inverseTrig/odderball/output/dxf/mcuHolder.dxf

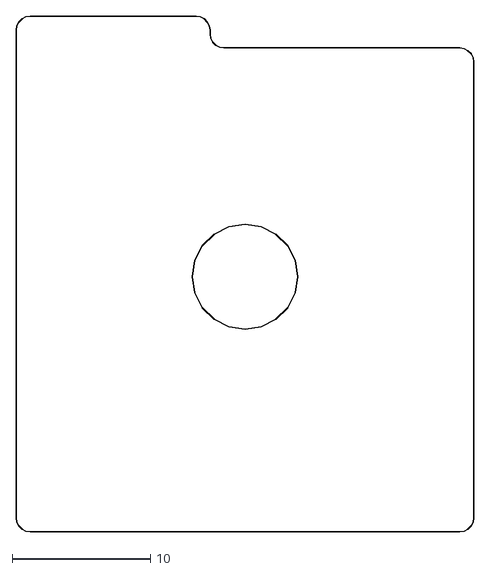
[picture p1: CAD file, 2024-08-11]
output/dxf/mcuHolder.dxf
33.0 x 37.2
