inverseTrig/odderball/src/modules/pcb.dxf

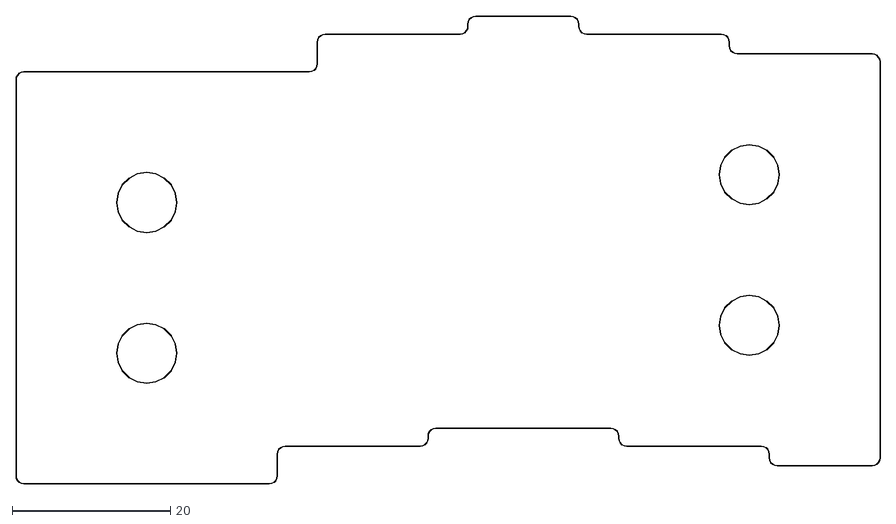
[picture p2: CAD file, 2024-08-10]
src/modules/pcb.dxf
109.3 x 59.1
