inverseTrig/odderball/output/dxf/rightThumbPlate.dxf

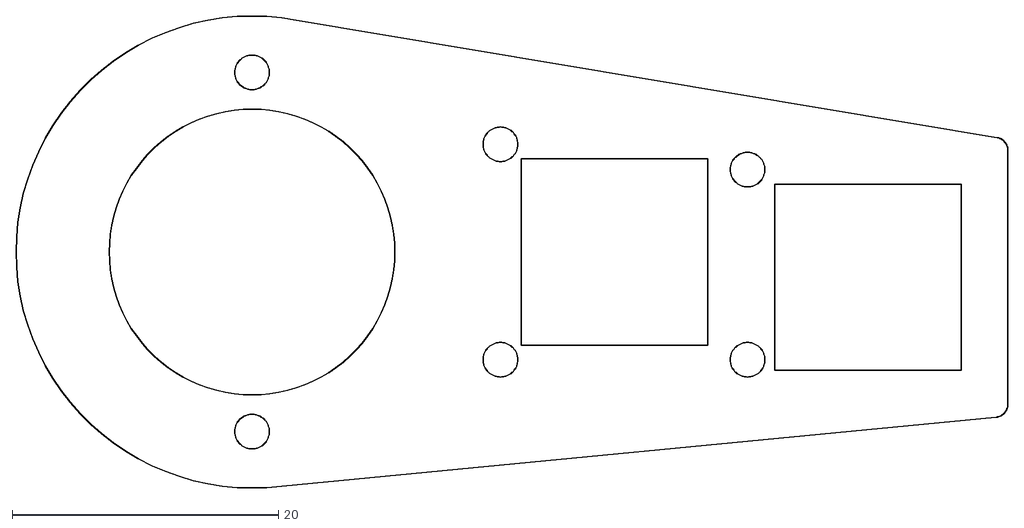
[picture p3: CAD file, 2024-08-10]
output/dxf/rightThumbPlate.dxf
74.6 x 35.5
