inverseTrig/odderball/src/modules/case.stl

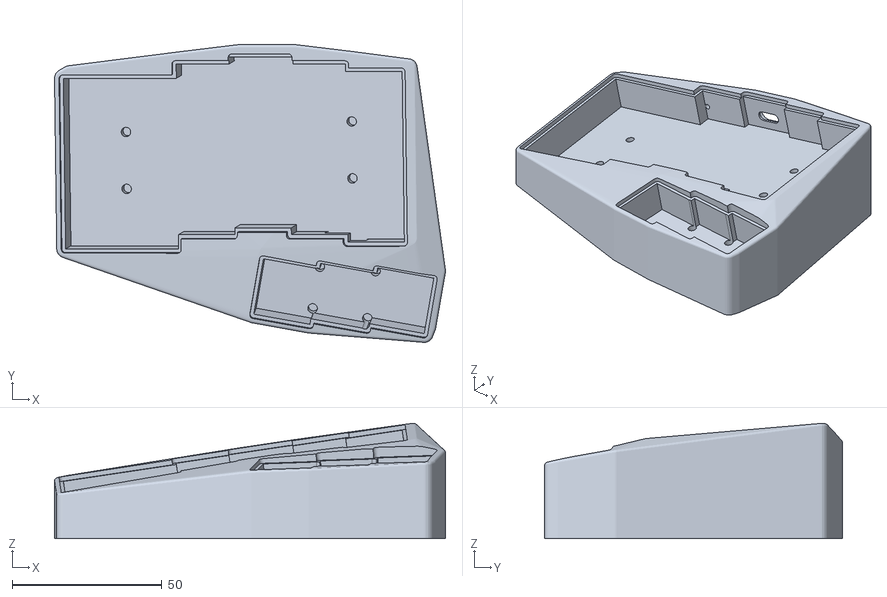
[picture p4: CAD file, 2024-08-10]
src/modules/case.stl
130.4 x 99.3 x 38.4
