inverseTrig/odderball/output/dxf/thumbPcb.dxf

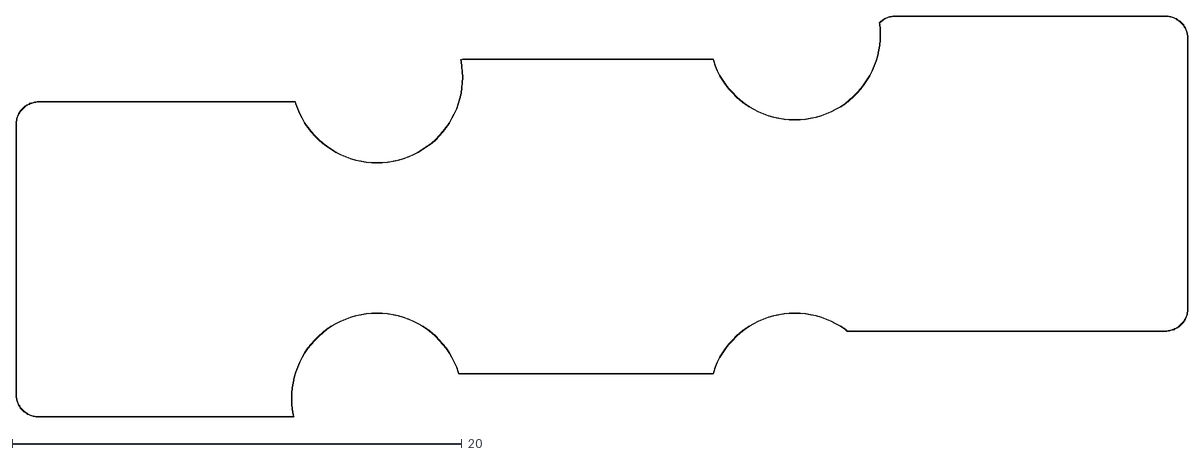
[picture p5: CAD file, 2024-08-10]
output/dxf/thumbPcb.dxf
52.1 x 17.8
