inverseTrig/odderball/output/dxf/leftThumbPlate.dxf

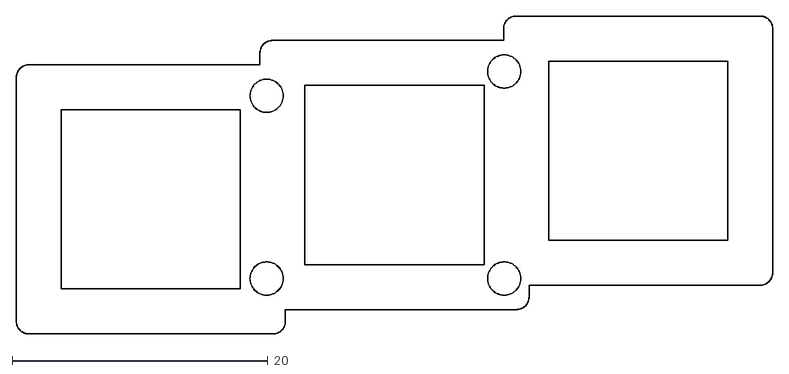
[picture p6: CAD file, 2024-08-10]
output/dxf/leftThumbPlate.dxf
59.2 x 24.9
