inverseTrig/odderball/src/components/thumbPcbDxf.scad

include<../config.scad>;
use<../modules/pcb.scad>;

pcb(
    THUMB_GRID,
    THUMB_BOLT_HOLES,
    1.00,
    $fn = 100);
