inverseTrig/odderball/(list of files, cad)

Other CAD files:
src/components/rightPlateDxf.scad
src/modules/leftCase.scad
