inverseTrig/odderball/pcb/odderball.kicad_pcb

## KiCad design pcb/odderball.kicad_pcb (2024-08-10)

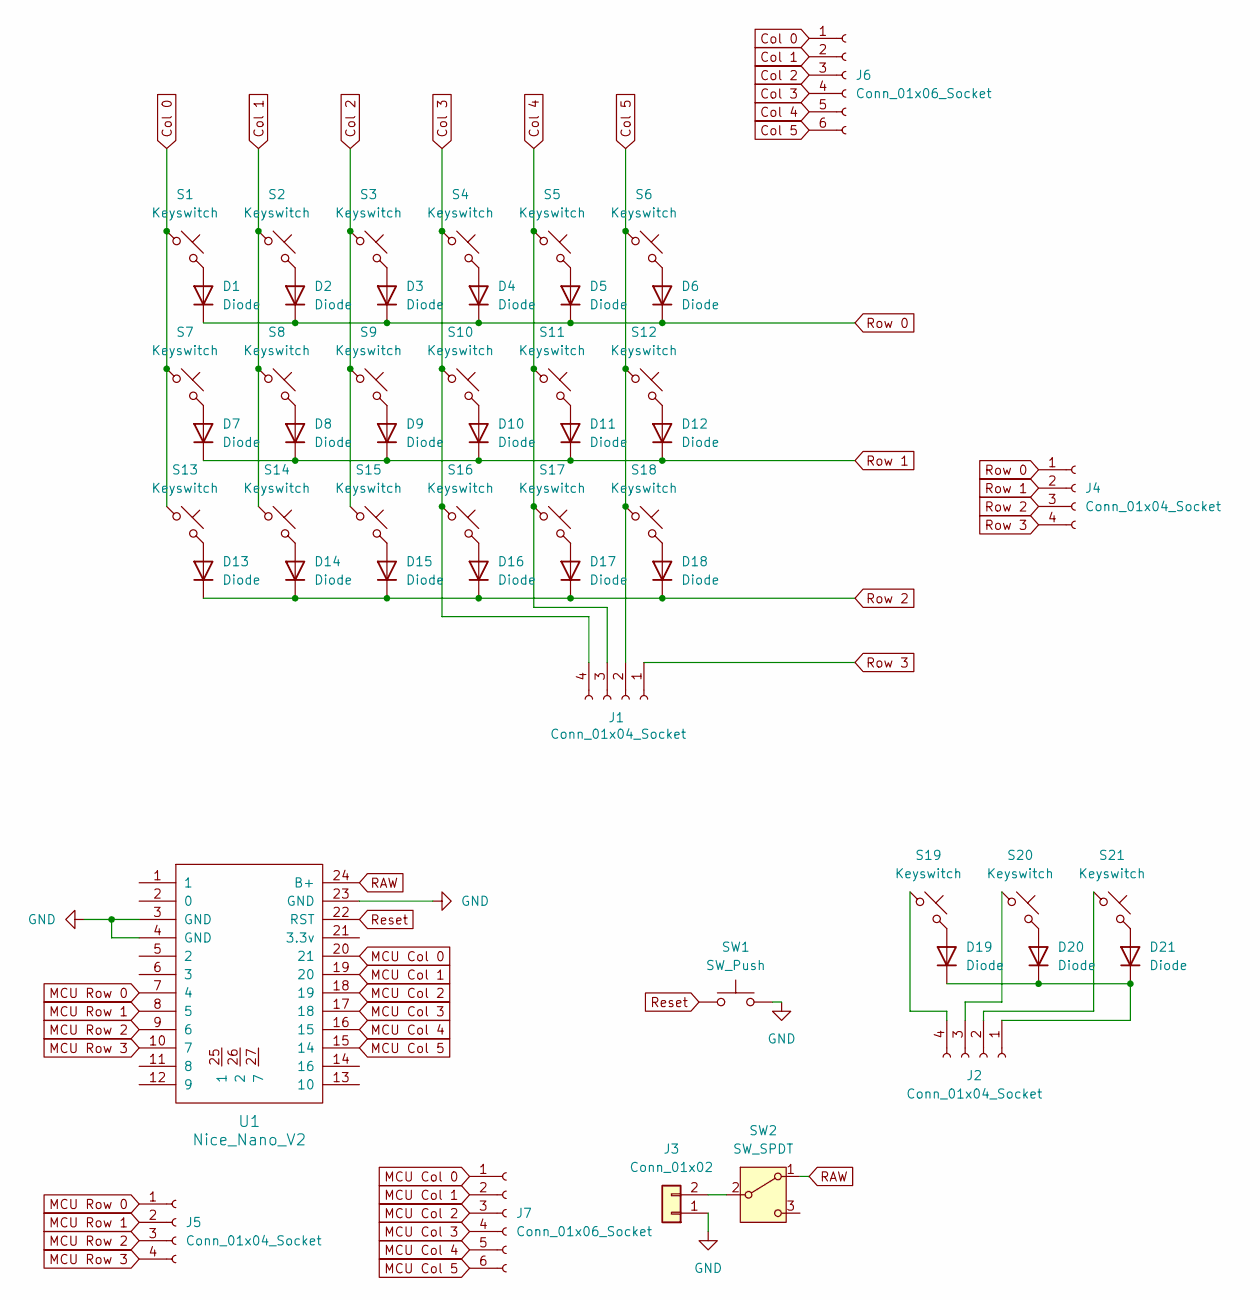
[picture p7: schematic odderball.kicad_sch]

Parts:
D1, D2, D3, D4, D5, D6, D7, D8, D9, D10, D11, D12, D13, D14, D15, D16, D17, D18, D19, D20, D21: Diode; Diode_TH_SOD123
J1, J2, J4, J5: Conn_01x04_Socket; PinSocket_1x04_P2.54mm_Vertical
J3: Conn_01x02; JST_PH_S2B-PH-SM4-TB_1x02-1MP_P2.00mm_Horizontal
J6, J7: Conn_01x06_Socket; PinSocket_1x06_P2.54mm_Vertical
S1, S2, S3, S4, S5, S6, S7, S8, S9, S10, S11, S12, S13, S14, S15, S16, S17, S18, S19, S20, S21: Keyswitch; MX_Solder_1.00u_Reversible
SW1: SW_Push; alps_sksn
SW2: SW_SPDT; switch_SSSS811101
U1: Nice_Nano_V2

Connections:
Col 0: J6.1, S1.1, S7.1, S13.1
Col 1: J6.2, S2.1, S8.1, S14.1
Col 2: J6.3, S3.1, S9.1, S15.1
Col 3: J1.4, J6.4, S4.1, S10.1, S16.1
Col 4: J1.3, J6.5, S5.1, S11.1, S17.1
Col 5: J1.2, J6.6, S6.1, S12.1, S18.1
GND: J3.1, SW1.2, U1.3 (GND), U1.4 (GND), U1.23 (GND)
MCU Col 0: J7.1, U1.20 (21)
MCU Col 1: J7.2, U1.19 (20)
MCU Col 2: J7.3, U1.18 (19)
MCU Col 3: J7.4, U1.17 (18)
MCU Col 4: J7.5, U1.16 (15)
MCU Col 5: J7.6, U1.15 (14)
MCU Row 0: J5.1, U1.7 (4)
MCU Row 1: J5.2, U1.8 (5)
MCU Row 2: J5.3, U1.9 (6)
MCU Row 3: J5.4, U1.10 (7)
unnamed: D1.2 (A), S1.2
unnamed: D2.2 (A), S2.2
unnamed: D3.2 (A), S3.2
unnamed: D4.2 (A), S4.2
unnamed: D5.2 (A), S5.2
unnamed: D6.2 (A), S6.2
unnamed: D7.2 (A), S7.2
unnamed: D8.2 (A), S8.2
unnamed: D9.2 (A), S9.2
unnamed: D10.2 (A), S10.2
unnamed: D11.2 (A), S11.2
unnamed: D12.2 (A), S12.2
unnamed: D13.2 (A), S13.2
unnamed: D14.2 (A), S14.2
unnamed: D15.2 (A), S15.2
unnamed: D16.2 (A), S16.2
unnamed: D17.2 (A), S17.2
unnamed: D18.2 (A), S18.2
unnamed: D19.2 (A), S19.2
unnamed: D19.1 (K), D20.1 (K), D21.1 (K), J2.1
unnamed: D20.2 (A), S20.2
unnamed: D21.2 (A), S21.2
unnamed: J2.2, S21.1
unnamed: J2.3, S20.1
unnamed: J2.4, S19.1
unnamed: J3.2, SW2.2 (B)
RAW: SW2.1 (A), U1.24 (B+)
Reset: SW1.1, U1.22 (RST)
Row 0: D1.1 (K), D2.1 (K), D3.1 (K), D4.1 (K), D5.1 (K), D6.1 (K), J4.1
Row 1: D7.1 (K), D8.1 (K), D9.1 (K), D10.1 (K), D11.1 (K), D12.1 (K), J4.2
Row 2: D13.1 (K), D14.1 (K), D15.1 (K), D16.1 (K), D17.1 (K), D18.1 (K), J4.3
Row 3: J1.1, J4.4

Board: 2 copper layers, 52 parts (21 on the bottom side), 49 nets, no tracks yet.
