inverseTrig/odderball/(commit log)

2024-07-26 feat: add extra thumb key; add more bolt holes for support; change thumb keys to 1u
    [case.scad, config.scad, leftCase.scad, rightCase.scad]
2024-07-26 feat: remove trrs
    [case.scad]
2024-08-10 feat: adding temporary pcb files, plate and pcb dxf related files; modifying case to use screw inserts
    [case.scad, case.stl, config.scad, leftPlateDxf.scad, leftThumbPlate.dxf, leftThumbPlateDxf.scad, odderball.kicad_pcb, odderball.kicad_sch]
2024-08-11 feat: adding pmw3610 cover
    [case.scad, config.scad, pmw3610Cover.scad]
2024-08-11 fix: cable cutout between thumb and pcb
    [case.scad]
2024-08-11 fix: add slight height to pmw3610 feet
    [pmw3610Cover.scad]
2024-08-11 wip: adding mcuholder
    [config.scad, mcuHolder.dxf, mcuHolder.scad]
